flyingperson23/BigCoilBoard/hardware2/BigCoilBoard.kicad_sch

## KiCad design hardware2/BigCoilBoard.kicad_sch (2025-09-02)

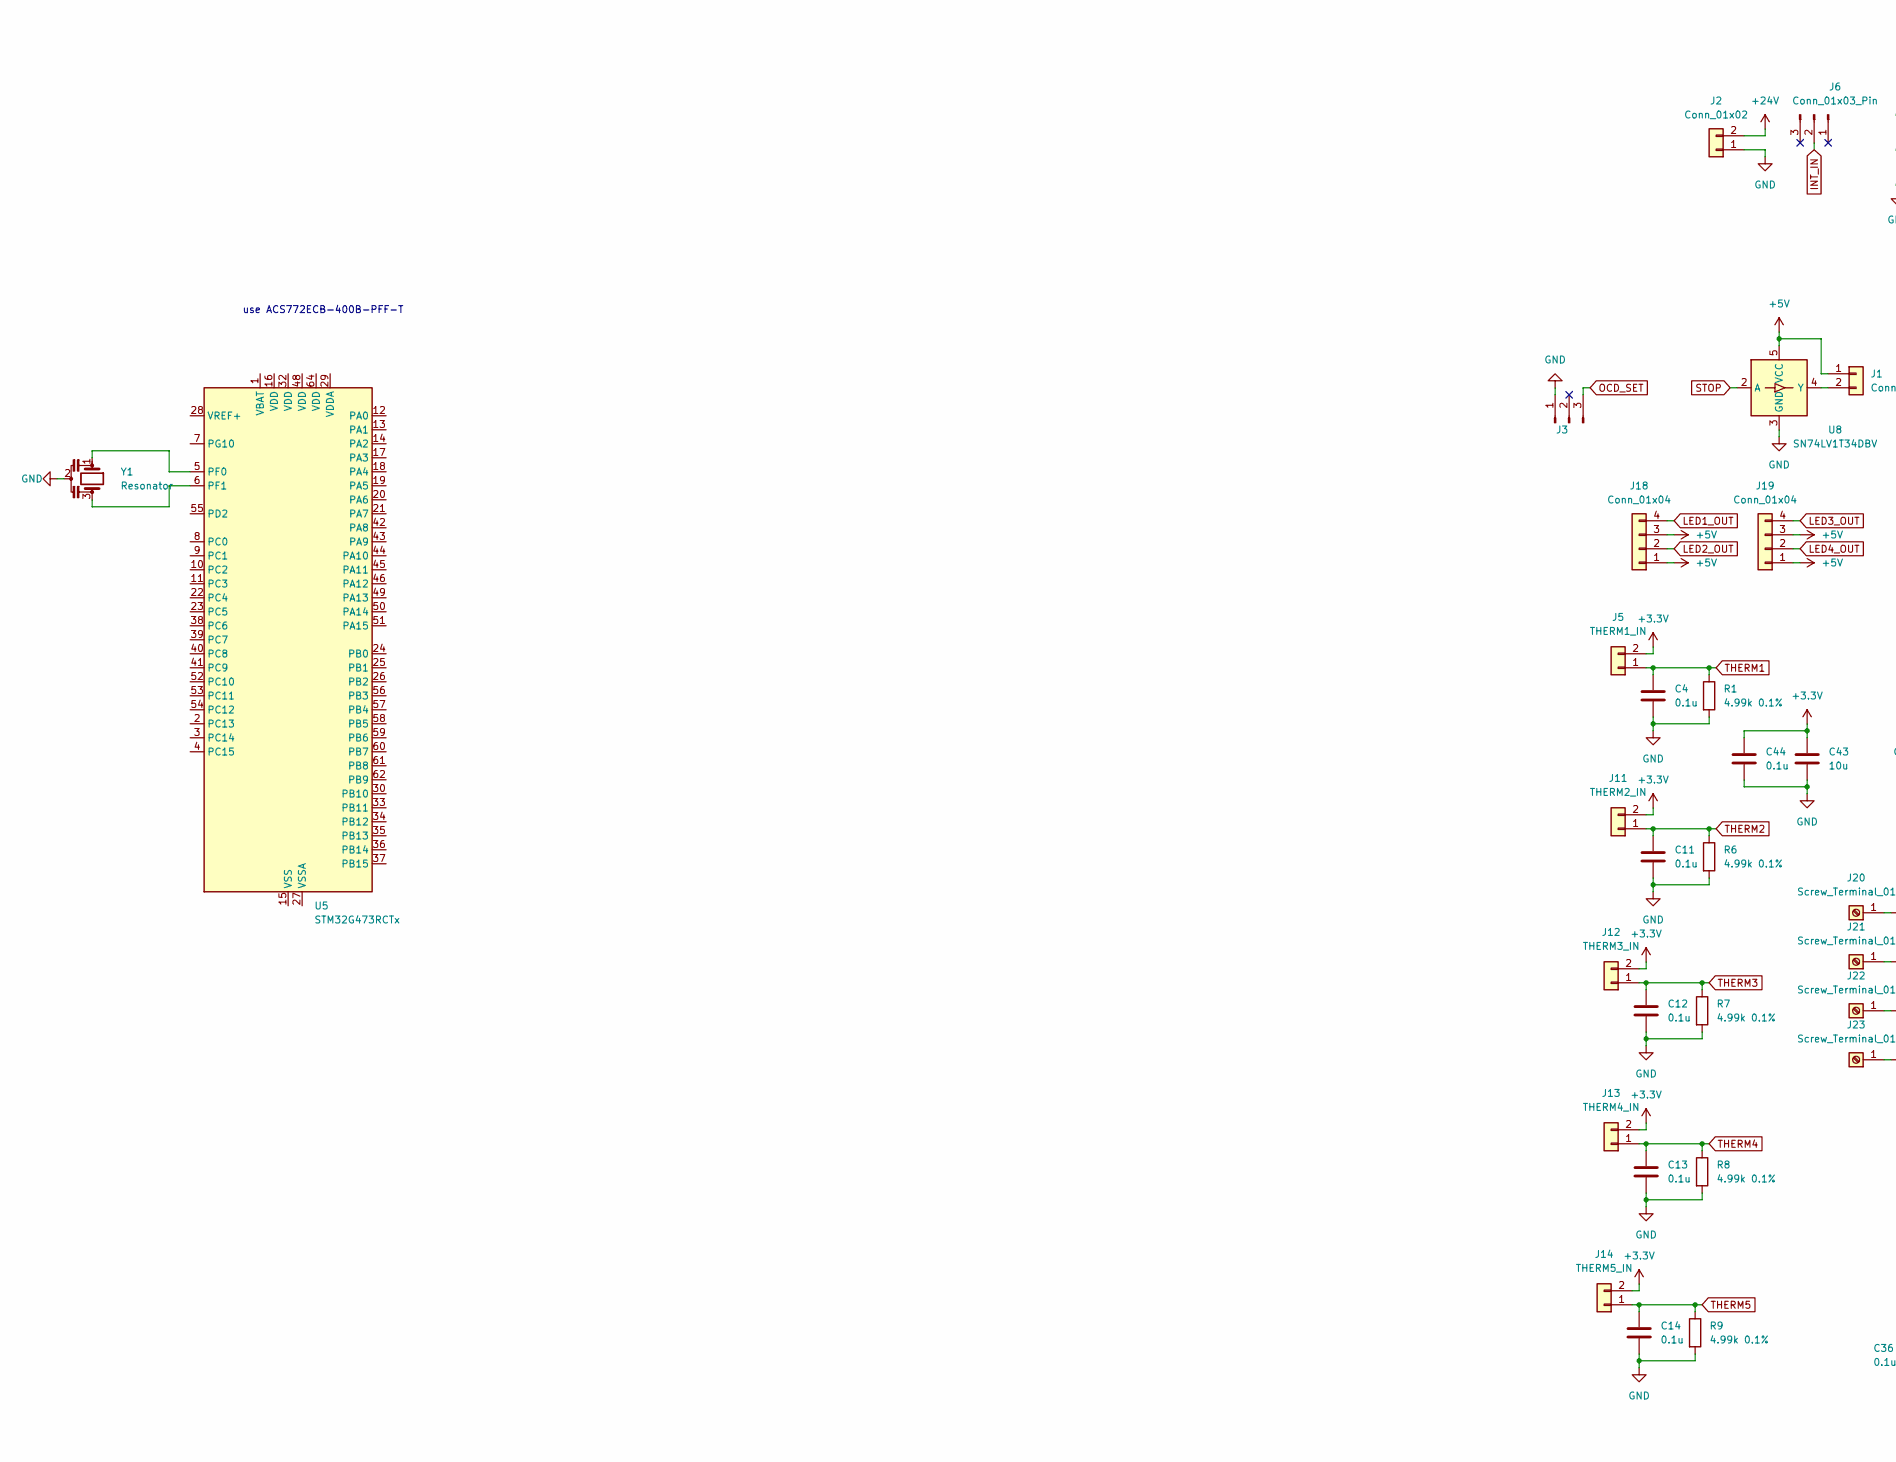
[picture p4: schematic BigCoilBoard.kicad_sch, part in row 1, column 1]

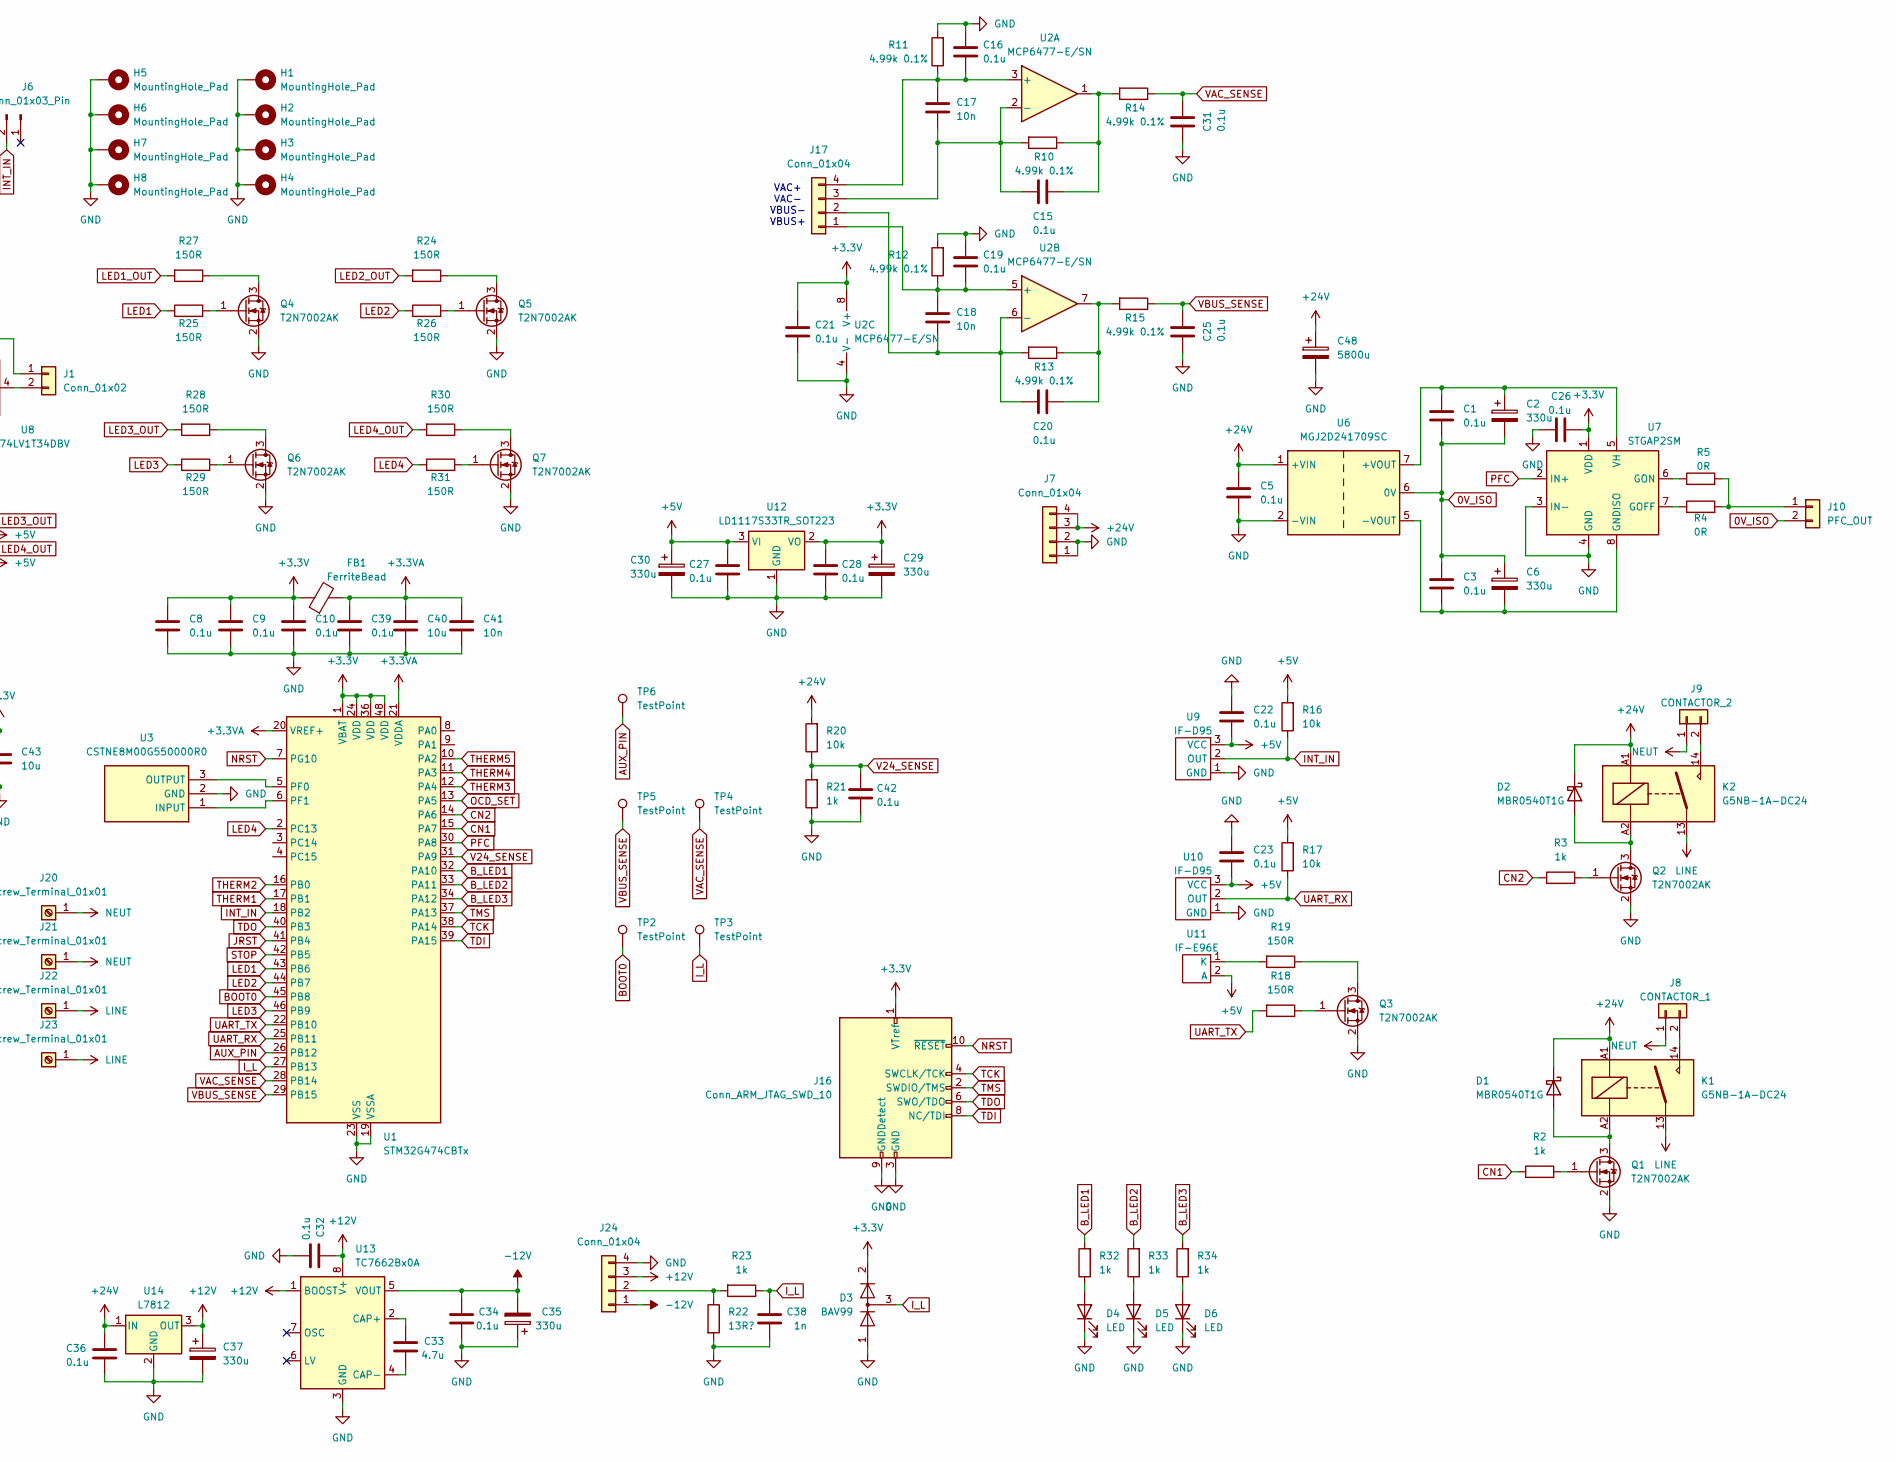
[picture p5: schematic BigCoilBoard.kicad_sch, part in row 1, column 2]

Parts:
C1, C3, C4, C5, C8, C9, C10, C11, C12, C13, C14, C15, C16, C19, C20, C21, C22, C23, C25, C26, C27, C28, C31, C32, C34, C36, C39, C42, C44: 0.1u; C_0805_2012Metric
C2, C6, C29, C30, C35, C37: 330u; 860020575013
C17, C18, C41: 10n; C_0805_2012Metric
C33: 4.7u; C_0805_2012Metric
C38: 1n; C_0805_2012Metric
C40, C43: 10u; C_0805_2012Metric
C48: 5800u; 860010581026
D1, D2: MBR0540T1G; D_SOD-123
D3: BAV99; SOT-23
D4, D5, D6: LED; LED_0805_2012Metric
FB1: FerriteBead; L_1206_3216Metric
H1, H2, H3, H4: MountingHole_Pad; MountingHole_2.7mm_M2.5_Pad_Via
H5, H6, H7, H8: MountingHole_Pad; MountingHole_4.3mm_M4_Pad_Via
J1, J2: Conn_01x02; PinSocket_1x02_P2.54mm_Vertical
J3, J6: Conn_01x03_Pin; PinSocket_1x03_P2.54mm_Vertical
J5: THERM1_IN; Molex_KK-254_AE-6410-02A_1x02_P2.54mm_Vertical
J7, J17, J18, J19, J24: Conn_01x04; Molex_KK-254_AE-6410-04A_1x04_P2.54mm_Vertical
J8: CONTACTOR_1; Molex_KK-254_AE-6410-02A_1x02_P2.54mm_Vertical
J9: CONTACTOR_2; Molex_KK-254_AE-6410-02A_1x02_P2.54mm_Vertical
J10: PFC_OUT; Molex_KK-254_AE-6410-02A_1x02_P2.54mm_Vertical
J11: THERM2_IN; Molex_KK-254_AE-6410-02A_1x02_P2.54mm_Vertical
J12: THERM3_IN; Molex_KK-254_AE-6410-02A_1x02_P2.54mm_Vertical
J13: THERM4_IN; Molex_KK-254_AE-6410-02A_1x02_P2.54mm_Vertical
J14: THERM5_IN; Molex_KK-254_AE-6410-02A_1x02_P2.54mm_Vertical
J16: Conn_ARM_JTAG_SWD_10; PinHeader_2x05_P1.27mm_Vertical
J20, J21, J22, J23: Screw_Terminal_01x01; Wuerth_REDCUBE-THR_WP-THRBU_74650074_THR
K1, K2: G5NB-1A-DC24; Relay_SPST_Omron_G5NB
Q1, Q2, Q3, Q4, Q5, Q6, Q7: T2N7002AK; SOT-23
R1, R6, R7, R8, R9, R10, R11, R12, R13, R14, R15: 4.99k 0.1%; R_0805_2012Metric
R2, R3, R21, R23, R32, R33, R34: 1k; R_0805_2012Metric
R4, R5: 0R; R_1210_3225Metric
R16, R17, R20: 10k; R_0805_2012Metric
R18, R19, R24, R25, R26, R27, R28, R29, R30, R31: 150R; R_0805_2012Metric
R22: 13R?; R_Axial_DIN0207_L6.3mm_D2.5mm_P10.16mm_Horizontal
TP2, TP3, TP4, TP5, TP6: TestPoint; TestPoint_Pad_2.0x2.0mm
U1: STM32G474CBTx; LQFP-48_7x7mm_P0.5mm
U2: MCP6477-E/SN; SOIC-8_3.9x4.9mm_P1.27mm
U3: CSTNE8M00G550000R0; Resonator_SMD_Murata_CSTxExxV-3Pin_3.0x1.1mm; Mouser Part Number 81-CSTNE8M00G550000R
U5: STM32G473RCTx; LQFP-64_10x10mm_P0.5mm
U6: MGJ2D241709SC; Converter_DCDC_Murata_MGJ2DxxxxxxSC_THT
U7: STGAP2SM; SOIC-8_3.9x4.9mm_P1.27mm
U8: SN74LV1T34DBV; SOT-23-5
U9, U10: IF-D95
U11: IF-E96E
U12: LD1117S33TR_SOT223; SOT-223-3_TabPin2
U13: TC7662Bx0A; SOIC-8_3.9x4.9mm_P1.27mm
U14: L7812; TO-220-3_Vertical
Y1: Resonator; Resonator_SMD_Murata_CSTxExxV-3Pin_3.0x1.1mm

Connections:
0V_ISO: C1.2, C2.2, C3.1, C6.1, J10.2, U6.6 (0V)
+3.3V: C8.1, C9.1, C10.1, C21.1, C26.2, C28.1, C29.1, C43.1, C44.1, D3.2 (A), FB1.1, J5.2, J11.2, J12.2, J13.2, J14.2, J16.1 (VTref), U1.1 (VBAT), U1.24 (VDD), U1.36 (VDD), U1.48 (VDD), U2.8 (V+), U7.1 (VDD), U12.2 (VO)
+3.3VA: C39.1, C40.1, C41.1, FB1.2, U1.20 (VREF+), U1.21 (VDDA)
+5V: C22.2, C23.2, C27.1, C30.1, J1.1, J18.1, J18.3, J19.1, J19.3, R16.2, R17.2, U8.5 (VCC), U9.3 (VCC), U10.3 (VCC), U11.2 (A), U12.3 (VI)
+12V: C32.1, C37.1, J24.3, U13.1 (BOOST), U13.8 (V+), U14.3 (OUT)
+24V: C5.1, C36.1, C48.1, D1.1 (K), D2.1 (K), J2.2, J7.3, J7.4, K1.A1, K2.A1, R20.2, U6.1 (+VIN), U14.1 (IN)
-12V: C34.2, C35.2, J24.1, U13.5 (VOUT)
AUX_PIN: TP6.1, U1.26 (PB12)
BOOT0: TP2.1, U1.45 (PB8)
B_LED1: R32.2, U1.32 (PA10)
B_LED2: R33.2, U1.33 (PA11)
B_LED3: R34.2, U1.34 (PA12)
CN1: R2.1, U1.15 (PA7)
CN2: R3.1, U1.14 (PA6)
GND: C4.2, C5.2, C8.2, C9.2, C10.2, C11.2, C12.2, C13.2, C14.2, C16.1, C19.1, C21.2, C22.1, C23.1, C25.2, C26.1, C27.2, C28.2, C29.2, C30.2, C31.2, C32.2, C34.1, C35.1, C36.2, C37.2, C38.1, C39.2, C40.2, C41.2, C42.2, C43.2, C44.2, C48.2, D3.1 (K), D4.1 (K), D5.1 (K), D6.1 (K), H1.1, H2.1, H3.1, H4.1, H5.1, H6.1, H7.1, H8.1, J2.1, J3.1, J7.1, J7.2, J16.3 (GND), J16.5 (GND), J16.9 (GNDDetect), J24.4, Q1.2 (S), Q2.2 (S), Q3.2 (S), Q4.2 (S), Q5.2 (S), Q6.2 (S), Q7.2 (S), R1.2, R6.2, R7.2, R8.2, R9.2, R11.2, R12.2, R21.1, R22.2, U1.19 (VSSA), U1.23 (VSS), U1.35 (VSS), U1.47 (VSS), U2.4 (V-), U3.2 (GND), U6.2 (-VIN), U7.3 (IN-), U7.4 (GND), U8.3 (GND), U9.1 (GND), U10.1 (GND), U12.1 (GND), U13.3 (GND), U14.2 (GND), Y1.2
INT_IN: J6.2, R16.1, U1.18 (PB2), U9.2 (OUT)
I_L: C38.2, D3.3 (K), R23.1, TP3.1, U1.27 (PB13)
JRST: U1.41 (PB4)
LED1: R25.1, U1.43 (PB6)
LED1_OUT: J18.4, R27.2
LED2: R26.1, U1.44 (PB7)
LED2_OUT: J18.2, R24.2
LED3: R29.1, U1.46 (PB9)
LED3_OUT: J19.4, R28.2
LED4: R31.1, U1.2 (PC13)
LED4_OUT: J19.2, R30.2
LINE: J22.1, J23.1, K1.13, K2.13
NEUT: J8.1, J9.1, J20.1, J21.1
NRST: J16.10 (~RESET), U1.7 (PG10)
unnamed: C1.1, C2.1, U6.7 (+VOUT), U7.5 (VH)
unnamed: C3.2, C6.2, U6.5 (-VOUT), U7.8 (GNDISO)
unnamed: C15.1, R10.1, R14.2, U2.1
unnamed: C15.2, C17.2, J17.3, R10.2, U2.2 (-)
unnamed: C16.2, C17.1, J17.4, R11.1, U2.3 (+)
unnamed: C18.1, C19.2, J17.1, R12.1, U2.5 (+)
unnamed: C18.2, C20.2, J17.2, R13.2, U2.6 (-)
unnamed: C20.1, R13.1, R15.2, U2.7
unnamed: C33.1, U13.4 (CAP-)
unnamed: C33.2, U13.2 (CAP+)
unnamed: D1.2 (A), K1.A2, Q1.3 (D)
unnamed: D2.2 (A), K2.A2, Q2.3 (D)
unnamed: D4.2 (A), R32.1
unnamed: D5.2 (A), R33.1
unnamed: D6.2 (A), R34.1
unnamed: J1.2, U8.4 (Y)
unnamed: J8.2, K1.14
unnamed: J9.2, K2.14
unnamed: J10.1, R4.2, R5.2
unnamed: J24.2, R22.1, R23.2
unnamed: Q1.1 (G), R2.2
unnamed: Q2.1 (G), R3.2
unnamed: Q3.1 (G), R18.1
unnamed: Q3.3 (D), R19.1
unnamed: Q4.1 (G), R25.2
unnamed: Q4.3 (D), R27.1
unnamed: Q5.1 (G), R26.2
unnamed: Q5.3 (D), R24.1
unnamed: Q6.1 (G), R29.2
unnamed: Q6.3 (D), R28.1
unnamed: Q7.1 (G), R31.2
unnamed: Q7.3 (D), R30.1
unnamed: R4.1, U7.7 (GOFF)
unnamed: R5.1, U7.6 (GON)
unnamed: R19.2, U11.1 (K)
unnamed: U1.5 (PF0), U3.3 (OUTPUT)
unnamed: U1.6 (PF1), U3.1 (INPUT)
unnamed: U5.5 (PF0), Y1.1
unnamed: U5.6 (PF1), Y1.3
unnamed: U5.15 (VSS), U5.31 (VSS), U5.47 (VSS), U5.63 (VSS)
OCD_SET: J3.3, U1.13 (PA5)
PFC: U1.30 (PA8), U7.2 (IN+)
STOP: U1.42 (PB5), U8.2 (A)
TCK: J16.4 (SWCLK/TCK), U1.38 (PA14)
TDI: J16.8 (NC/TDI), U1.39 (PA15)
TDO: J16.6 (SWO/TDO), U1.40 (PB3)
THERM1: C4.1, J5.1, R1.1, U1.17 (PB1)
THERM2: C11.1, J11.1, R6.1, U1.16 (PB0)
THERM3: C12.1, J12.1, R7.1, U1.12 (PA4)
THERM4: C13.1, J13.1, R8.1, U1.11 (PA3)
THERM5: C14.1, J14.1, R9.1, U1.10 (PA2)
TMS: J16.2 (SWDIO/TMS), U1.37 (PA13)
UART_RX: R17.1, U1.25 (PB11), U10.2 (OUT)
UART_TX: R18.2, U1.22 (PB10)
V24_SENSE: C42.1, R20.1, R21.2, U1.31 (PA9)
VAC_SENSE: C31.1, R14.1, TP4.1, U1.28 (PB14)
VBUS_SENSE: C25.1, R15.1, TP5.1, U1.29 (PB15)

Notes on the sheet:
VAC+ VAC- VBUS- VBUS+
use ACS772ECB-400B-PFF-T
