flyingperson23/BigCoilBoard/int_adc/BigCoilBoard.ioc

Mcu.UserName=STM32G474CBTx
PA10.GPIO_Label=BLED1
PA10.Signal=GPIO_Output
PA11.GPIO_Label=BLED2
PA11.Signal=GPIO_Output
PA12.GPIO_Label=BLED3
PA12.Signal=GPIO_Output
PA13.Signal=SYS_JTMS-SWDIO
PA14.Signal=SYS_JTCK-SWCLK
PA15.Signal=SYS_JTDI
PA2.GPIO_Label=THERM5
PA2.Signal=ADC1_IN3
PA3.GPIO_Label=THERM4
PA3.Signal=ADC1_IN4
PA4.GPIO_Label=THERM3
PA4.Signal=ADC2_IN17
PA5.GPIO_Label=OCD_OUT
PA5.Signal=COMP_DAC12_group
PA6.GPIO_Label=CN2
PA6.Signal=GPIO_Output
PA7.GPIO_Label=CN1
PA7.Signal=GPIO_Output
PA8.GPIO_Label=PFC
PA8.Signal=S_TIM1_CH1
PA9.GPIO_Label=V24_SENSE
PA9.Signal=ADC5_IN2
PB0.GPIO_Label=THERM2
PB0.Signal=ADC1_IN15
PB1.GPIO_Label=THERM1
PB1.Signal=ADC1_IN12
PB10.Signal=USART3_TX
PB11.Signal=USART3_RX
PB13.GPIO_Label=I_L_SENSE
PB13.Signal=SharedAnalog_PB13
PB14.GPIO_Label=VAC_SENSE
PB14.Signal=ADC4_IN4
PB15.GPIO_Label=VBUS_SENSE
PB15.Signal=ADC4_IN5
PB2.GPIO_Label=INT_IN
PB2.Signal=GPXTI2
PB3.Signal=SYS_JTDO-SWO
PB4.Signal=SYS_JTRST
PB5.GPIO_Label=STOP
PB5.Signal=GPIO_Output
PB6.GPIO_Label=LED1
PB6.Signal=GPIO_Output
PB7.GPIO_Label=LED2
PB7.Signal=GPIO_Output
PB9.GPIO_Label=LED3
PB9.Signal=GPIO_Output
PC13.GPIO_Label=LED4
PC13.Signal=GPIO_Output
PF0-OSC_IN.Signal=RCC_OSC_IN
PF1-OSC_OUT.Signal=RCC_OSC_OUT
