flyingperson23/BigCoilBoard/int_adc/Core/Inc/main.h

#define LED4_Pin GPIO_PIN_13
#define LED4_GPIO_Port GPIOC
#define THERM5_Pin GPIO_PIN_2
#define THERM5_GPIO_Port GPIOA
#define THERM4_Pin GPIO_PIN_3
#define THERM4_GPIO_Port GPIOA
#define THERM3_Pin GPIO_PIN_4
#define THERM3_GPIO_Port GPIOA
#define OCD_OUT_Pin GPIO_PIN_5
#define OCD_OUT_GPIO_Port GPIOA
#define CN2_Pin GPIO_PIN_6
#define CN2_GPIO_Port GPIOA
#define CN1_Pin GPIO_PIN_7
#define CN1_GPIO_Port GPIOA
#define THERM2_Pin GPIO_PIN_0
#define THERM2_GPIO_Port GPIOB
#define THERM1_Pin GPIO_PIN_1
#define THERM1_GPIO_Port GPIOB
#define INT_IN_Pin GPIO_PIN_2
#define INT_IN_GPIO_Port GPIOB
#define INT_IN_EXTI_IRQn EXTI2_IRQn
#define I_L_SENSE_Pin GPIO_PIN_13
#define I_L_SENSE_GPIO_Port GPIOB
#define VAC_SENSE_Pin GPIO_PIN_14
#define VAC_SENSE_GPIO_Port GPIOB
#define VBUS_SENSE_Pin GPIO_PIN_15
#define VBUS_SENSE_GPIO_Port GPIOB
#define PFC_Pin GPIO_PIN_8
#define PFC_GPIO_Port GPIOA
#define V24_SENSE_Pin GPIO_PIN_9
#define V24_SENSE_GPIO_Port GPIOA
#define BLED1_Pin GPIO_PIN_10
#define BLED1_GPIO_Port GPIOA
#define BLED2_Pin GPIO_PIN_11
#define BLED2_GPIO_Port GPIOA
#define BLED3_Pin GPIO_PIN_12
#define BLED3_GPIO_Port GPIOA
#define STOP_Pin GPIO_PIN_5
#define STOP_GPIO_Port GPIOB
#define LED1_Pin GPIO_PIN_6
#define LED1_GPIO_Port GPIOB
#define LED2_Pin GPIO_PIN_7
#define LED2_GPIO_Port GPIOB
#define LED3_Pin GPIO_PIN_9
#define LED3_GPIO_Port GPIOB
