flyingperson23/BigCoilBoard/(commit log)

2025-03-11 internal adc software
    [BigCoilBoard.kicad_pcb, BigCoilBoard.kicad_sch]
2025-04-02 back to int adc
    [BigCoilBoard-B_Cu.gbr, BigCoilBoard-B_Mask.gbr, BigCoilBoard-B_Paste.gbr, BigCoilBoard-B_Silkscreen.gbr, BigCoilBoard-Edge_Cuts.gbr, BigCoilBoard-F_Cu.gbr, BigCoilBoard-F_Mask.gbr, BigCoilBoard-F_Paste.gbr]
2025-10-01 v3 work, implemented dcm pfc in v2
    [BigCoilBoard.kicad_sch]
